Sudo-Guts/SPWM/PCB/SPWM.kicad_pcb

## KiCad design PCB/SPWM.kicad_pcb (2026-10-16)

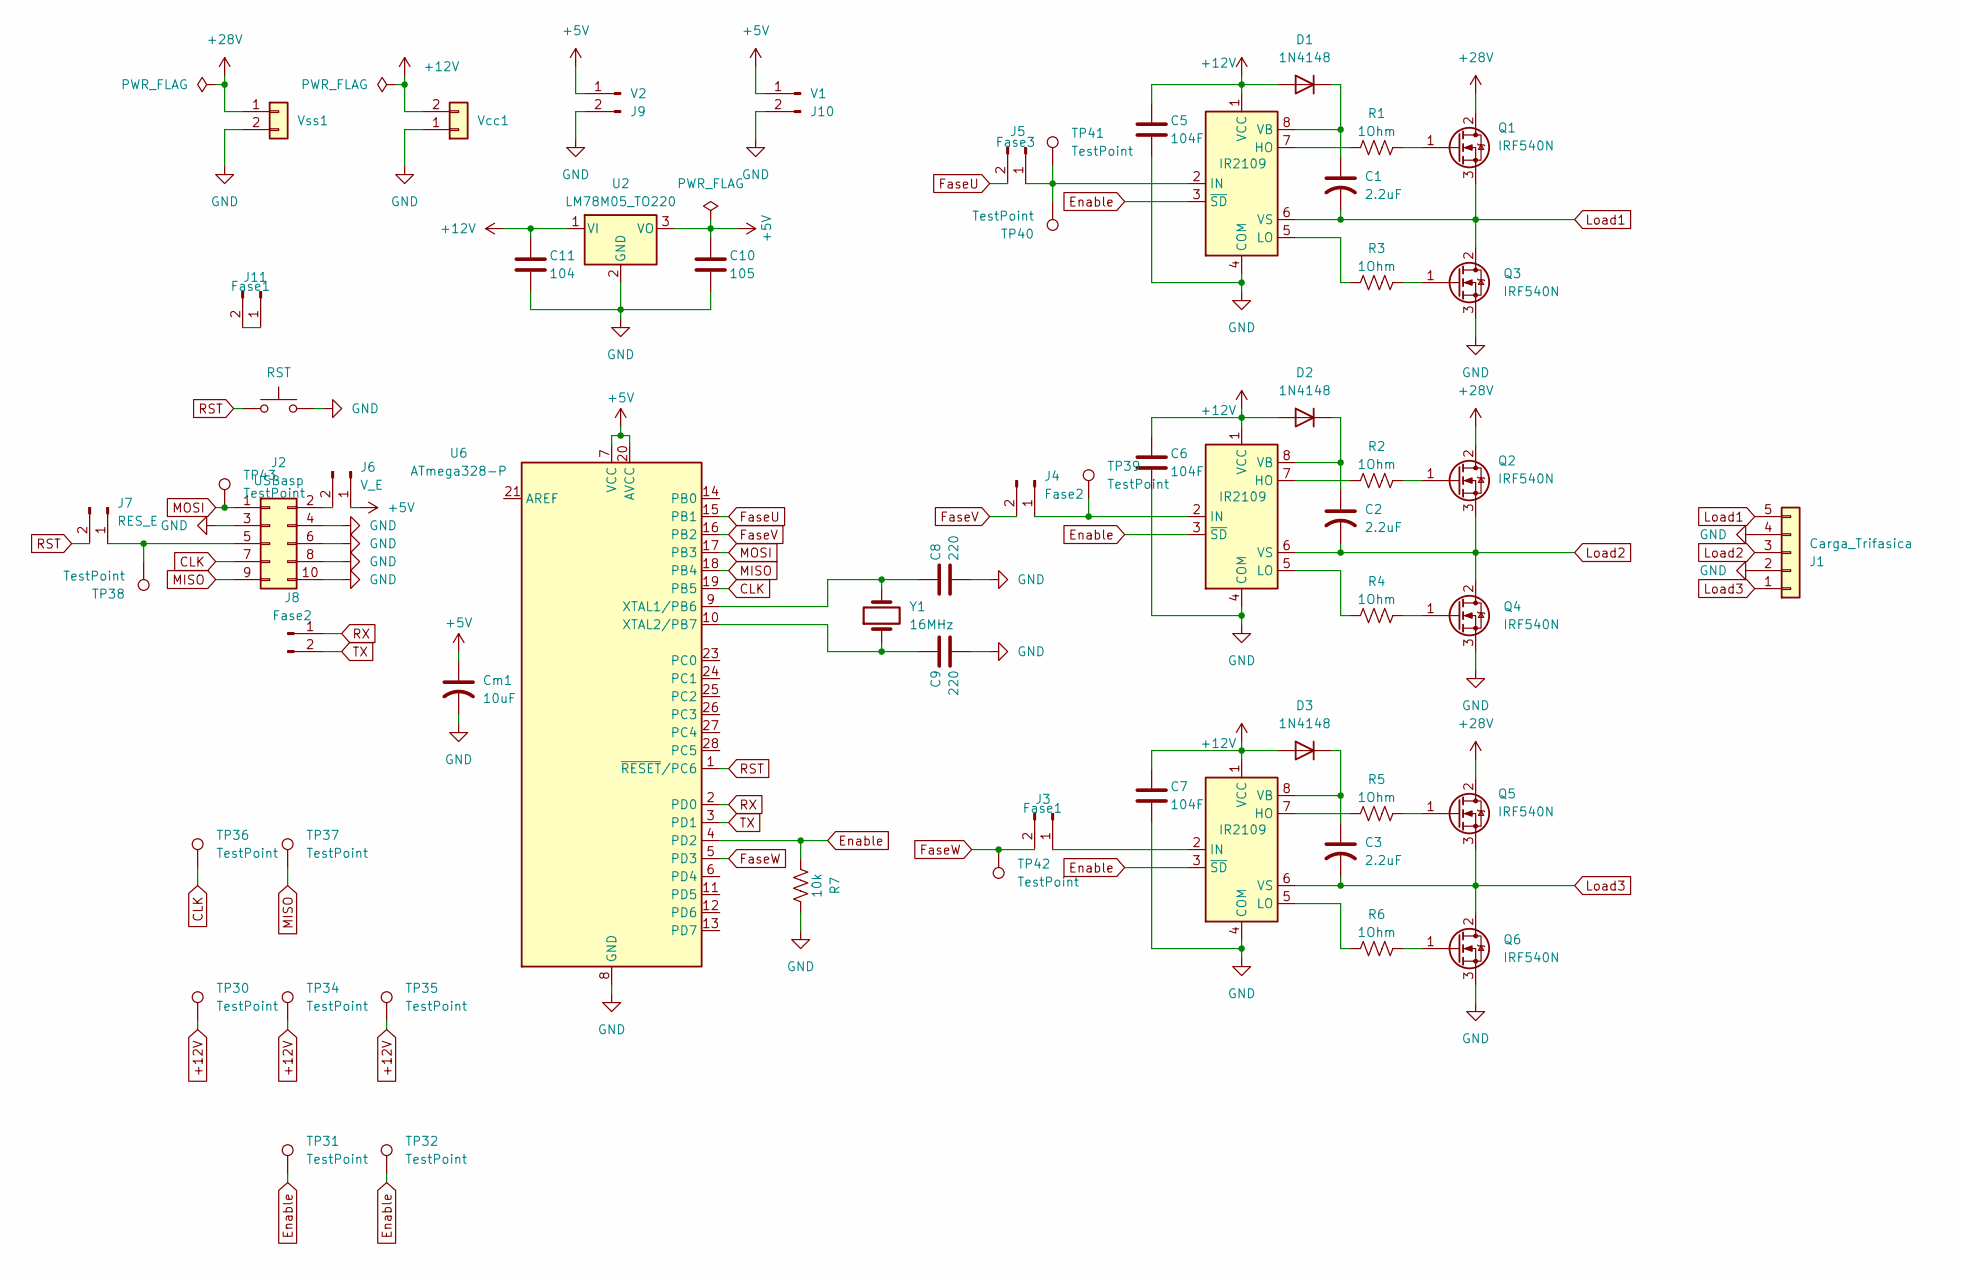
[picture p1: schematic SPWM.kicad_sch]

Parts:
C1, C2, C3: 2.2uF; CP_Radial_D4.0mm_P2.00mm
C5, C6, C7: 104F; CP_Radial_Tantal_D5.0mm_P5.00mm
C8, C9: 220; CP_Radial_Tantal_D5.0mm_P5.00mm
C10: 105; CP_Radial_Tantal_D5.0mm_P5.00mm
C11: 104; CP_Radial_Tantal_D5.0mm_P5.00mm
Cm1: 10uF; CP_Radial_D4.0mm_P2.00mm
D1, D2, D3: 1N4148; D_DO-35_SOD27_P7.62mm_Horizontal
J1: Carga_Trifasica; TerminalBlock_MaiXu_MX126-5.0-05P_1x05_P5.00mm
J2: USBasp; IDC-Header_2x05_P2.54mm_Vertical
J3, J11: Fase1; PinHeader_1x02_P2.54mm_Vertical
J4, J8: Fase2; PinHeader_1x02_P2.54mm_Vertical
J5: Fase3; PinHeader_1x02_P2.54mm_Vertical
J6: V_E; PinHeader_1x02_P2.54mm_Vertical
J7: RES_E; PinHeader_1x02_P2.54mm_Vertical
J9: V2; PinHeader_1x02_P2.54mm_Vertical
J10: V1; PinHeader_1x02_P2.54mm_Vertical
Q1, Q2, Q3, Q4, Q5, Q6: IRF540N; TO-220-3_Vertical
R1, R2, R3, R4, R5, R6: 1Ohm; R_Axial_DIN0309_L9.0mm_D3.2mm_P12.70mm_Horizontal
R7: 10k; R_Axial_DIN0309_L9.0mm_D3.2mm_P12.70mm_Horizontal
SW1: RST; SW_PUSH_6mm_H7.3mm
TP30, TP31, TP32, TP34, TP35, TP36, TP37, TP38, TP39, TP40, TP41, TP42, TP43: TestPoint; TestPoint_Bridge_Pitch7.62mm_Drill1.3mm
U1, U4, U5: IR2109; DIP-8_W7.62mm_Socket
U2: LM78M05_TO220; TO-220-3_Vertical
U6: ATmega328-P; DIP-28_W7.62mm
Vcc1: Conn_01x02; TerminalBlock_MaiXu_MX126-5.0-02P_1x02_P5.00mm
Vss1: Conn_01x02; TerminalBlock_MaiXu_MX126-5.0-02P_1x02_P5.00mm
Y1: 16MHz; Crystal_HC49-4H_Vertical

Connections:
+5V: C10.1, Cm1.1, J6.1, J9.1 (Pin_1_1), J10.1 (Pin_1_1), U2.3 (VO), U6.7 (VCC), U6.20 (AVCC)
+12V: C5.1, C6.1, C7.1, C11.1, D1.2 (A), D2.2 (A), D3.2 (A), TP30.1 (1_1), TP34.1 (1_1), TP35.1 (1_1), U1.1 (VCC), U2.1 (VI), U4.1 (VCC), U5.1 (VCC), Vcc1.2 (Pin_2_2)
+28V: Q1.2 (D), Q2.2 (D), Q5.2 (D), Vss1.1 (Pin_1_1)
CLK: J2.7, TP36.1 (1_1), U6.19 (PB5)
Enable: R7.1, TP31.1 (1_1), TP32.1 (1_1), U1.3 (~SD), U4.3 (~SD), U5.3 (~SD), U6.4 (PD2)
FaseU: J5.2, U6.15 (PB1)
FaseV: J4.2, U6.16 (PB2)
FaseW: J3.2, TP42.1 (1_1), U6.5 (PD3)
Load1: C1.2, J1.5, Q1.3 (S), Q3.2 (D), U1.6 (VS)
Load2: C2.2, J1.3, Q2.3 (S), Q4.2 (D), U4.6 (VS)
Load3: C3.2, J1.1, Q5.3 (S), Q6.2 (D), U5.6 (VS)
MISO: J2.9, TP37.1 (1_1), U6.18 (PB4)
MOSI: J2.1, TP43.1 (1_1), U6.17 (PB3)
unnamed: C1.1, D1.1 (K), U1.8 (VB)
unnamed: C2.1, D2.1 (K), U4.8 (VB)
unnamed: C3.1, D3.1 (K), U5.8 (VB)
unnamed: J2.2, J6.2
unnamed: J2.5, J7.1, TP38.1 (1_1)
unnamed: J3.1, U5.2 (IN)
unnamed: J4.1, TP39.1 (1_1), U4.2 (IN)
unnamed: J5.1, TP40.1 (1_1), TP41.1 (1_1), U1.2 (IN)
unnamed: J11.1, J11.2
unnamed: Q1.1 (G), R1.2
unnamed: Q2.1 (G), R2.2
unnamed: Q3.1 (G), R3.2
unnamed: Q4.1 (G), R4.2
unnamed: Q5.1 (G), R5.2
unnamed: Q6.1 (G), R6.2
unnamed: R1.1, U1.7 (HO)
unnamed: R3.1, U1.5 (LO)
unnamed: R2.1, U4.7 (HO)
unnamed: R4.1, U4.5 (LO)
unnamed: R5.1, U5.7 (HO)
unnamed: R6.1, U5.5 (LO)
unnamed: C8.1, U6.9 (XTAL1/PB6), Y1.2
unnamed: C9.1, U6.10 (XTAL2/PB7), Y1.1
RST: J7.2, SW1.1 (1_1), U6.1 (~RESET/PC6)
RX: J8.1, U6.2 (PD0)
TX: J8.2, U6.3 (PD1)

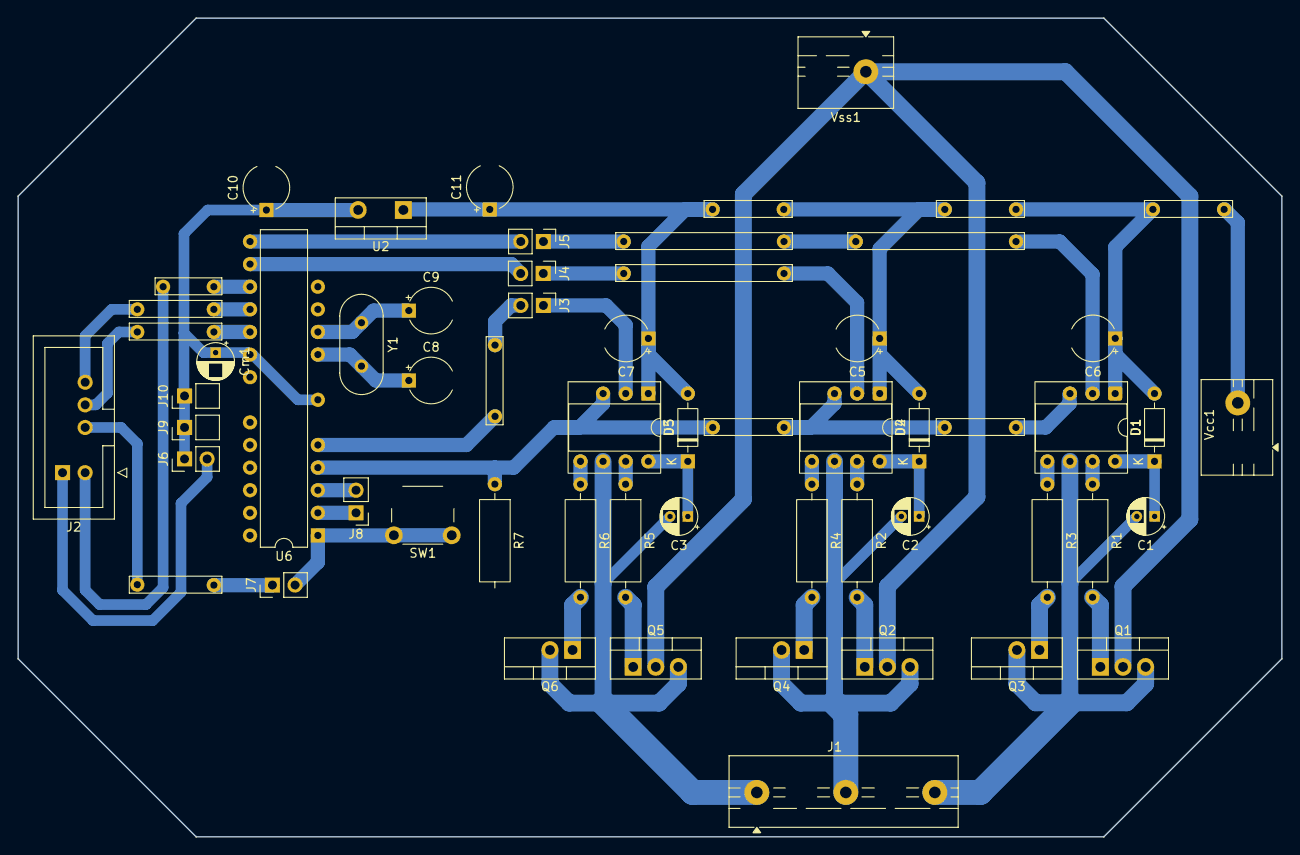
[picture p2: board SPWM.kicad_pcb from above]

Board: 2 copper layers, 142.0 x 92.0 mm, 59 parts (0 on the bottom side), 38 nets.
